456789123/Canara_UnB/Esquema.png

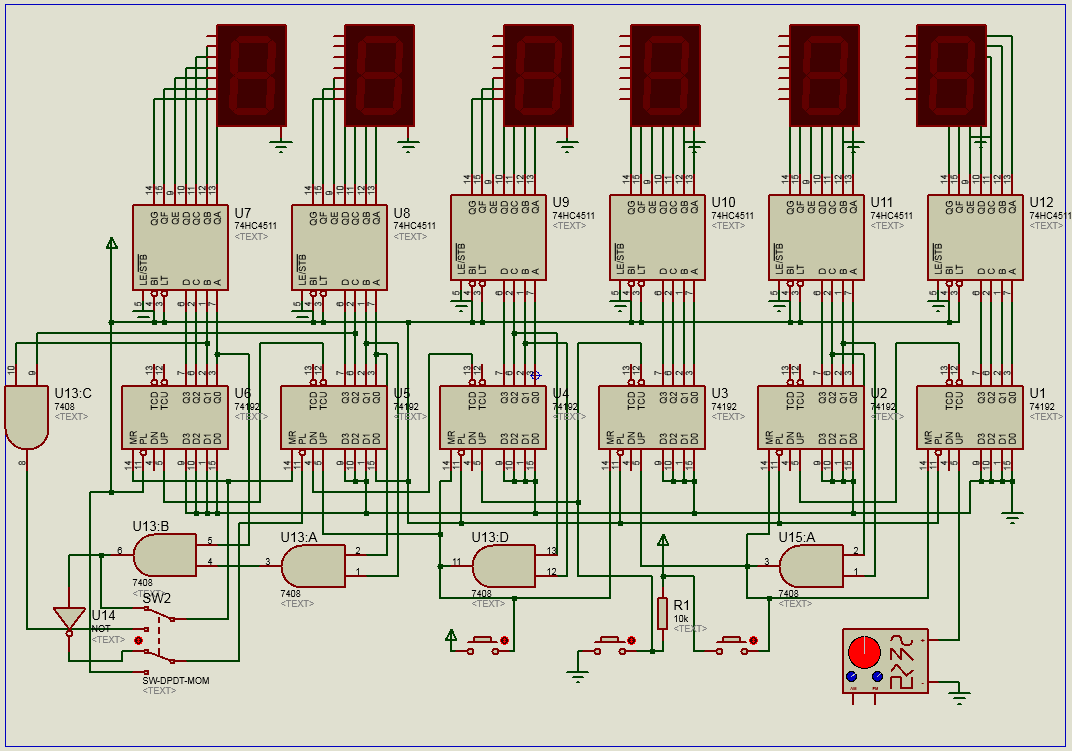
Esquema.png
