456789123/Canara_UnB/Fotos/20160711_222927.jpg

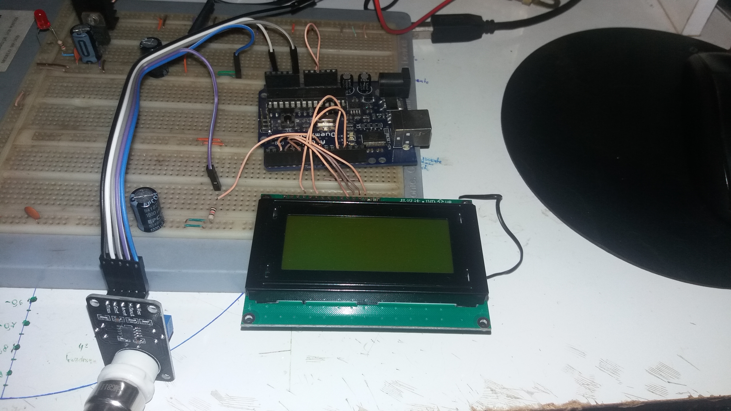
Fotos/20160711_222927.jpg
