456789123/Canara_UnB/Fotos/caldeira.jpg

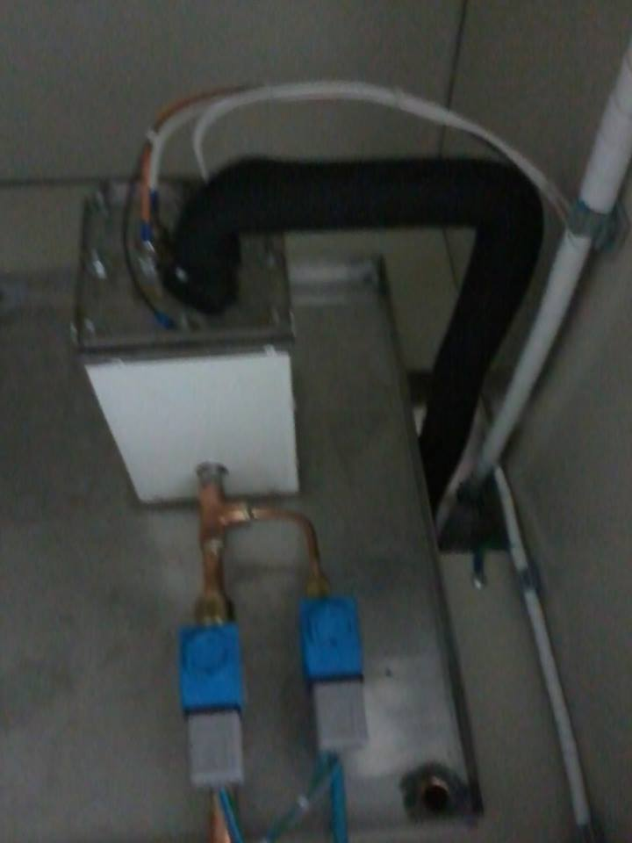
Fotos/caldeira.jpg
