456789123/Canara_UnB/Fotos/Finalizada/WhatsApp Image 2017-02-01 at 20.18.00 (14).jpeg

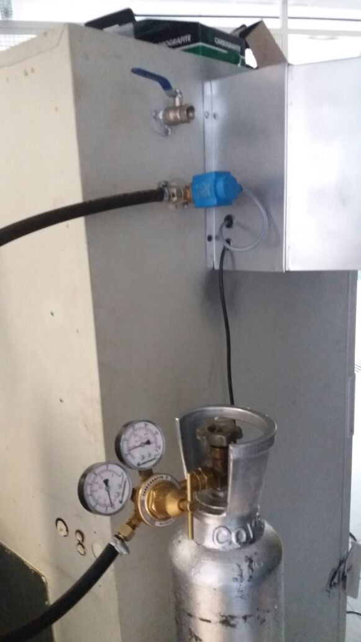
Fotos/Finalizada/WhatsApp Image 2017-02-01 at 20.18.00 (14).jpeg
