456789123/Canara_UnB/Fotos/WhatsApp Image 2016-07-09 at 20.50.44.jpeg

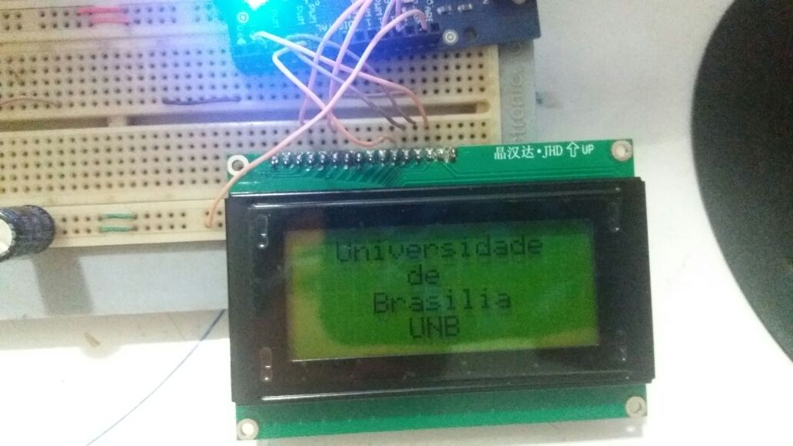
Fotos/WhatsApp Image 2016-07-09 at 20.50.44.jpeg
