456789123/Canara_UnB/Fotos/WhatsApp Image 2016-07-10 at 04.58.34.jpeg

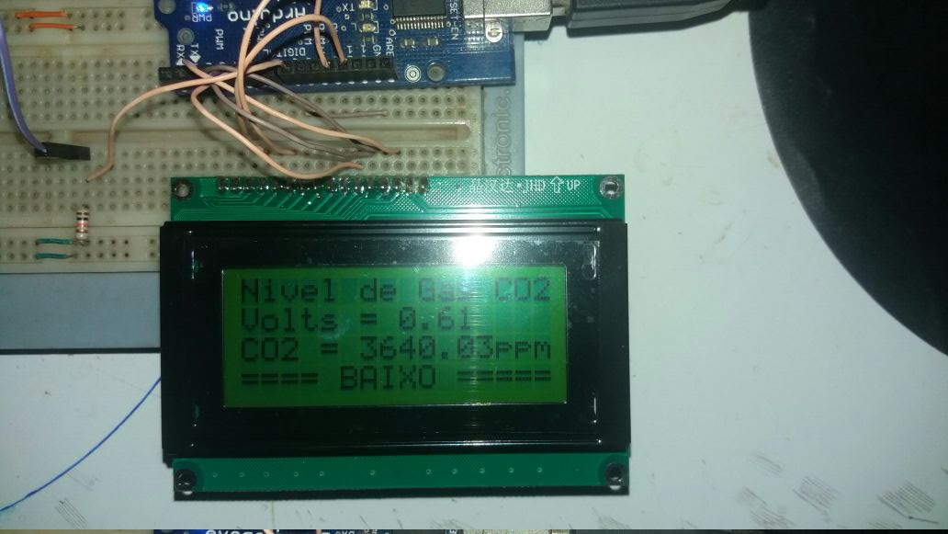
Fotos/WhatsApp Image 2016-07-10 at 04.58.34.jpeg
