456789123/Canara_UnB/Fotos/WhatsApp Image 2016-09-20 at 21.24.50.jpeg

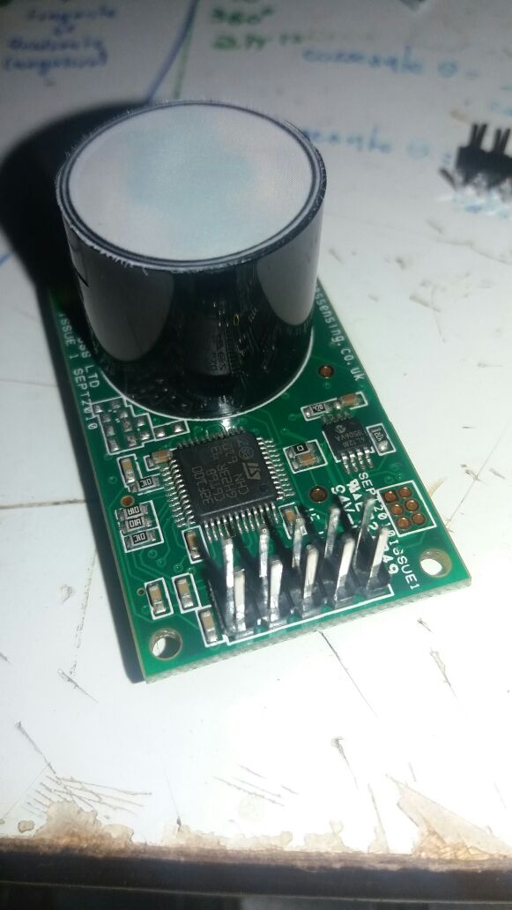
Fotos/WhatsApp Image 2016-09-20 at 21.24.50.jpeg
