456789123/Canara_UnB/Fotos/WhatsApp Image 2016-09-20 at 23.27.36.jpeg

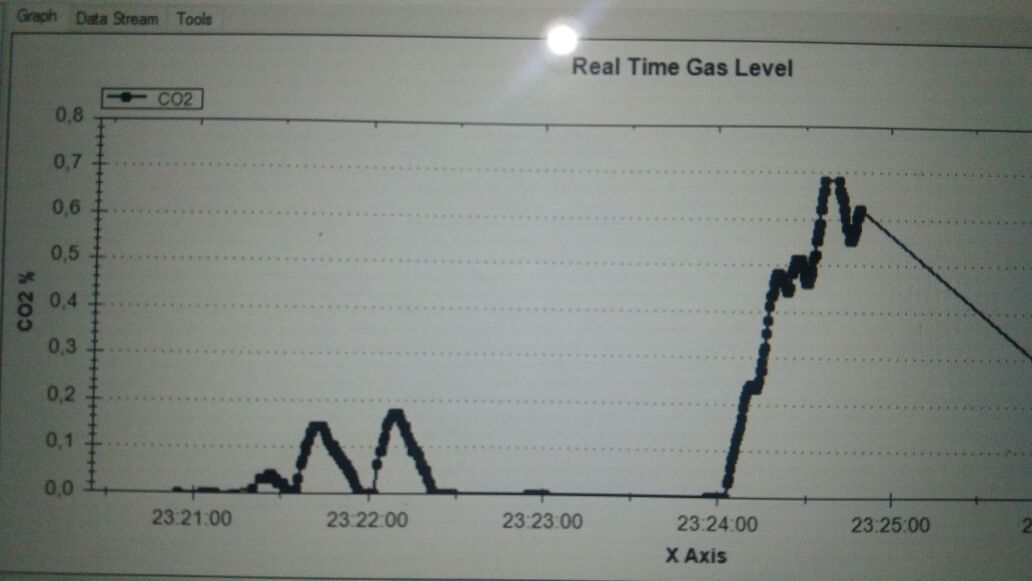
Fotos/WhatsApp Image 2016-09-20 at 23.27.36.jpeg
