456789123/Canara_UnB/Fotos/WhatsApp Image 2016-09-28 at 15.24.20.jpeg

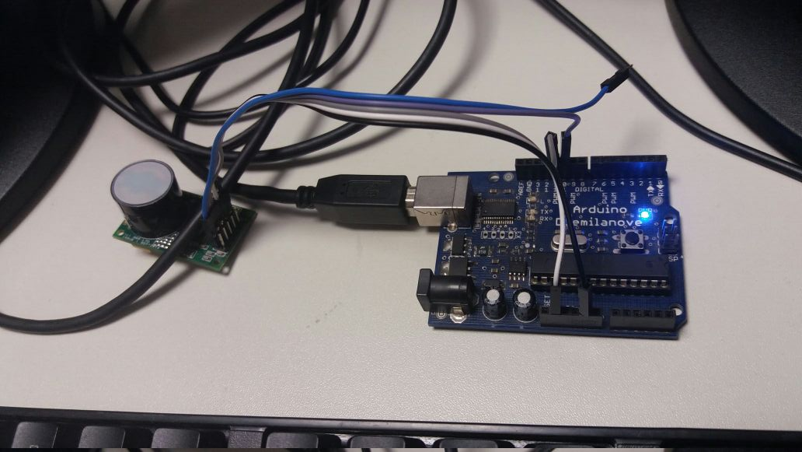
Fotos/WhatsApp Image 2016-09-28 at 15.24.20.jpeg
