456789123/Canara_UnB/Listas_de_materiais/Lista de materiais.ods

Material para câmara de CO²
Componentes | Quantidade | Valor unitário | Valor Frete | Valor | Onde Encontrar
Sensor de Dióxido de Carbono | 2 | 170,00 | Grátis | 340,00 | http://www.ebay.com/itm/CO2-Carbon-Dioxide-Sensor-with-Analog-Signal-TTL-Level-Temperature-Output-/271664310826
Sensor de umidade e temperatura | 2 | 7,95 | 28,97 | 15,90 | http://produto.mercadolivre.com.br/MLB-737856386-sensor-de-umidade-do-ar-e-temperatura-dht11-dht-11-arduino-_JM
Display lcd 4 linhas por 20 colunas: | 2 | 35,00 | 22,08 | 70,00 | http://produto.mercadolivre.com.br/MLB-706672691-display-lcd-20x4-backlight-azul-escrita-branca-_JM
Placa Arduino | 1 | 70,00 | 22,43 | 70,00 | http://produto.mercadolivre.com.br/MLB-712797484-arduino-mega-2560-r3-cabo-usb-made-in-italy-_JM
Fotoacoplador 4N45 | 5 | 1,50 | Grátis | 7,50 | http://produto.mercadolivre.com.br/MLB-693585886-4n35-4-n35-foto-acoplador-_JM
Transformador 12V/1,5Ampéres | 1 | 20,00 | Grátis | 20,00 | http://produto.mercadolivre.com.br/MLB-750767816-transformador-bivolt-127-220-para-12v-2-amperes-_JM
Capacitores eletrolíticos 1000uf 25 Volts | 4 | 1,00 | Grátis | 4,00 | http://produto.mercadolivre.com.br/MLB-697843310-capacitor-eletrolitico-1000uf-25v-pacote-com-2-so-r100-_JM
Placa ilhada 10 cm x 20 cm | 1 | 20,00 | Grátis | 20,00 | http://eletronicos.mercadolivre.com.br/pecas-componentes-eletricos-outros/placa-ilhada
Rolo de fio vermelho, verde, preto e amarelo (bitola 0,5 mm2) | 4 | 30,00 | Grátis | 120,00 | http://produto.mercadolivre.com.br/MLB-695172585-rolo-de-fio-050-mm2-para-som-automotivo-remoto-100-mts-_JM
Solenóide para o gás e o vapor | 2 |  |  | 0,00
Umidificador de ar | 1 | 50,00 | 77,81 | 50,00 | http://produto.mercadolivre.com.br/MLB-740146948-umidificador-de-ar-usb-com-lmpada-cristal-e-luz-noturna-_JM
Chave PBS-11B Verde Sem Trava 2T (Tipo Push Button) | 6 | 0,66 | Grátis | 3,96 | http://www.soldafria.com.br/chave-pbs-11b-verde-sem-trava-2t-tipo-push-button-p-5879.html
Borne KF-103 3 Terminais Verde 45 Graus | 8 | 1,50 | Grátis | 12,00 | http://www.soldafria.com.br/borne-kf-103-3-terminais-verde-45-graus-p-1577.html
Bta26-600b Triac 26a-600v | 5 | 1,50 | Grátis | 7,50 | http://produto.mercadolivre.com.br/MLB-709196643-bta26-600b-triac-26a-600v-_JM
Total |  |  |  | 740,86 | Demais componentes terei em minha residência
Mão de obra | 2.800,00
 |  |  | Total tudo | 3.540,86
