456789123/Canara_UnB/(commit log)

2017-03-25 Projeto de uma câmara de Carbonização para experimentos com amostras de concretos.
    [Lista de materiais.ods, Nova lista de materiais.ods]
2017-04-17 Arduino Uno
    Plataforma de desenvolvimento Arduino Uno.
2017-04-17 Esquemário
    Esquemário do circuito de controle para a câmara de carbonização.
2017-04-17 Telas de amostragens
    Telas para amostragem de parâmetros configurações de controle.
2017-04-17 Documentação
    Relatório de apresentação para o controle da câmara de carbonetação.
2017-04-17 Documentação
    Relatório de funcionamento do controle de gás para a câmara de carbonetação.
